nkito/i960_sbc/schematic/i960_Dev.pdf

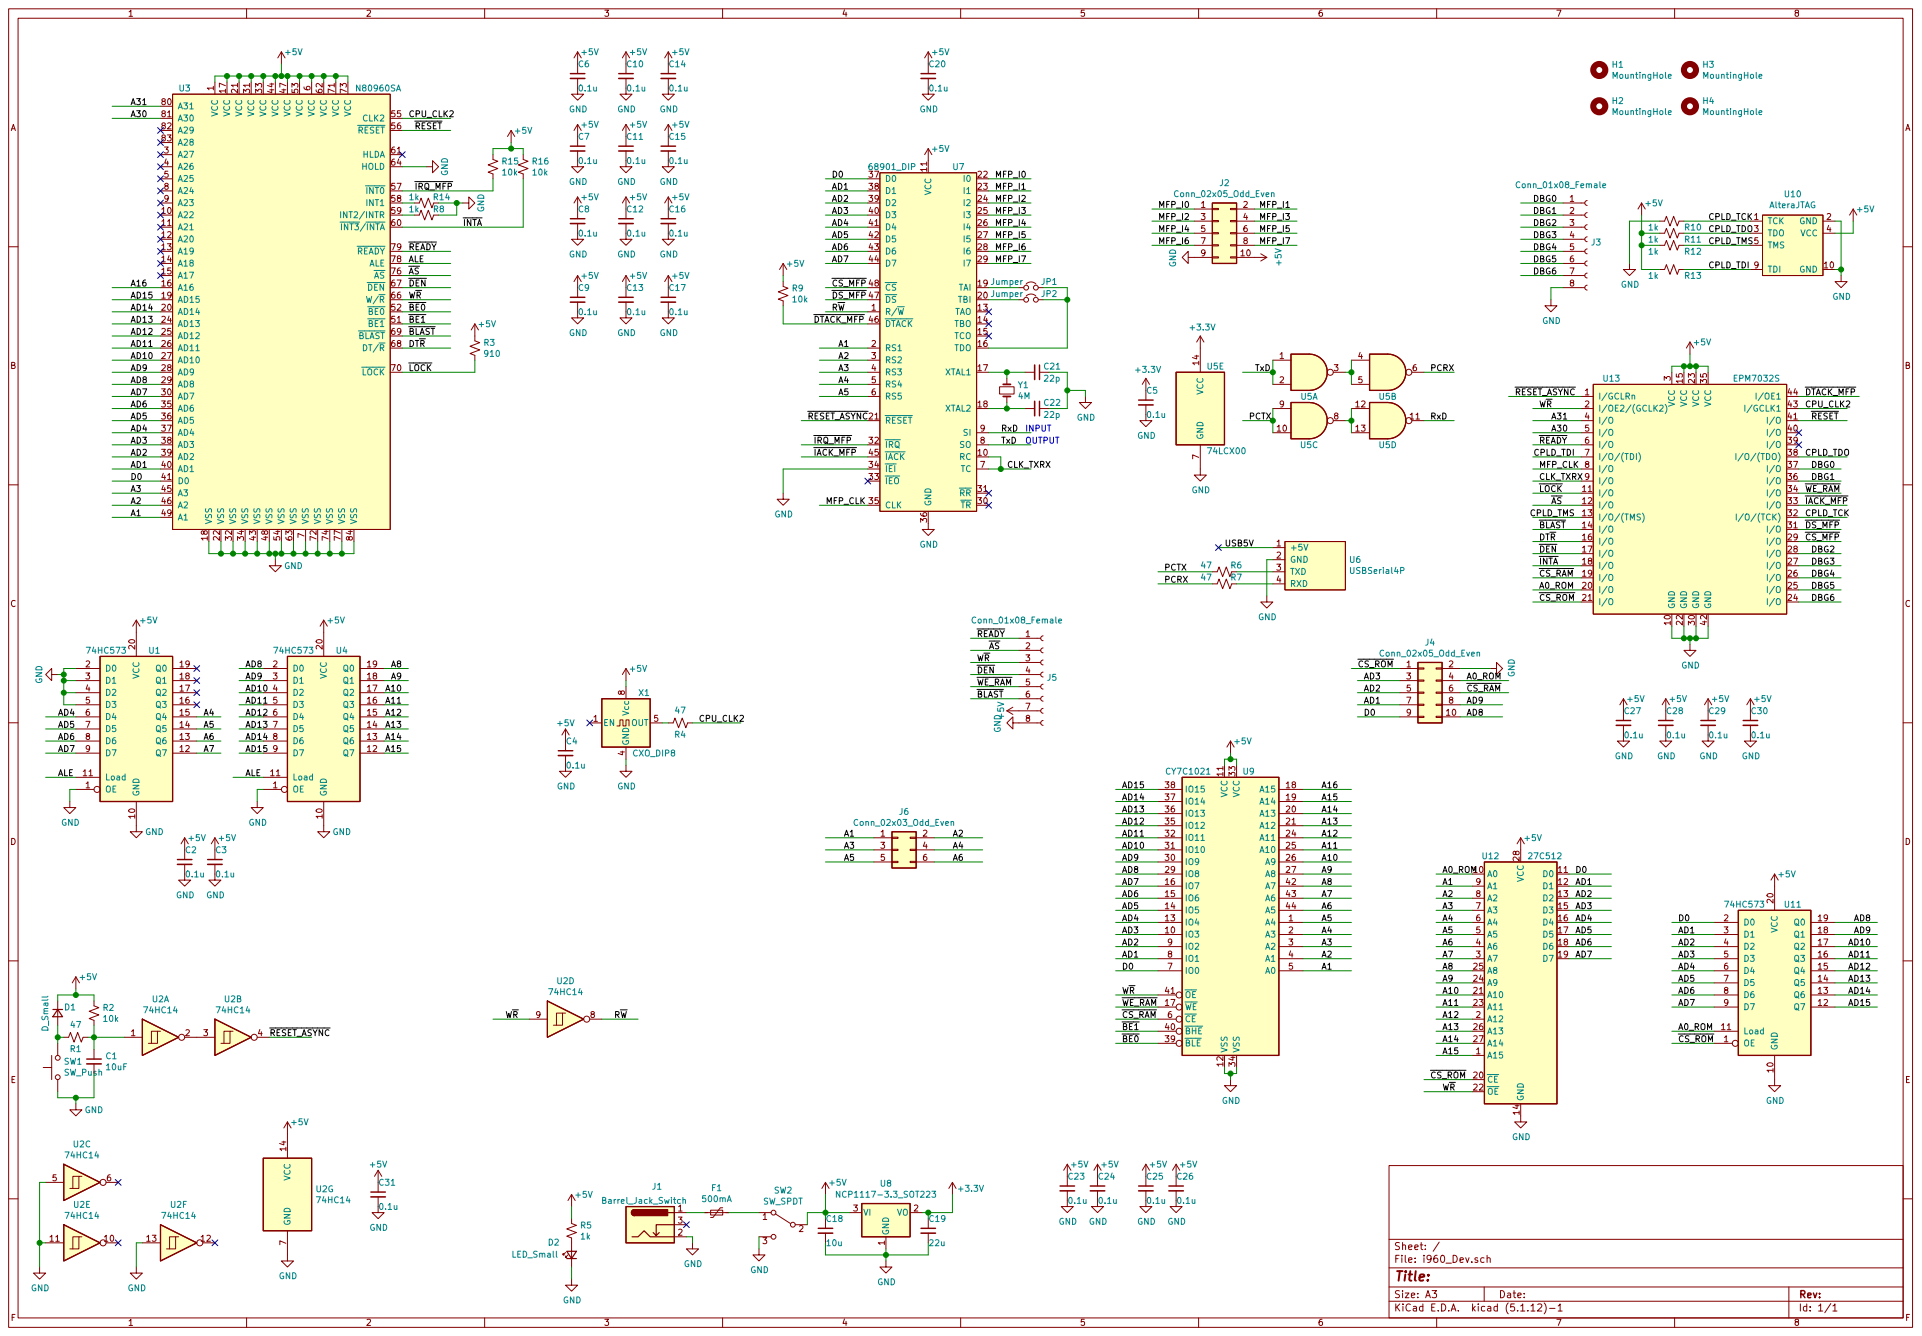
[picture p3: page 1]

1 A22 10 A21 11 A20 12 A19 13 A18 14 A17 15 A16 16 VCC 17 VSS 18 AD15 19 AD14 20 VCC 21 VSS 22 AD13 24 AD12 25 AD11 26 AD10 27 AD9 28 AD8 29 A27 3 AD7 30 VCC 31 VSS 32 VCC 33 VSS 34 AD6 35 AD5 36 AD4 37 AD3 38 AD2 39 A26 4 AD1 40 D0 41 VSS 43 VCC 44 A3 45 A2 46 VCC 47 VSS 48 A1 49 A25 5 BE1 51 BE0 52 VCC 53 VSS 54 CLK2 55 RESET 56

4 OUT 5 Vcc 8X1 CXO_DIP8 +5V VCC 14 GND

File: i960_Dev.sch Sheet: / GND
